krzysiek344/ucore-sevo_driver-integration/hw/rtl/soc/uart_receiver.sv

/* Copyright (C) 2025  AGH University of Krakow */

module uart_receiver (
    input logic        clk,
    input logic        rst_n,

    input logic        sck_rising_edge,
    input logic [7:0]  edges_per_bit,

    output logic       busy,
    output logic       error,
    output logic       rx_data_valid,
    output logic [7:0] rx_data,

    input logic        sin
);


/* User defined types */

typedef enum logic [1:0] {
    IDLE,
    START,
    ACTIVE,
    STOP
} state_t;


/* Local variables and signals */

state_t     state, state_nxt;

logic       rx_data_valid_nxt;
logic [7:0] rx_data_nxt;
logic [2:0] bits_counter, bits_counter_nxt;
logic [7:0] edges_counter, edges_counter_nxt;
logic [7:0] rx_buffer, rx_buffer_nxt;
logic       error_nxt;


/* Module internal logic */

/* State controller */

always_ff @(posedge clk or negedge rst_n) begin
    if (!rst_n) begin
        state <= IDLE;
        bits_counter <= 3'b0;
        edges_counter <= 8'b0;
    end else begin
        state <= state_nxt;
        bits_counter <= bits_counter_nxt;
        edges_counter <= edges_counter_nxt;
    end
end

always_comb begin
    state_nxt = state;
    bits_counter_nxt = bits_counter;
    edges_counter_nxt = edges_counter;

    case (state)
    IDLE: begin
        if (!sin)
            state_nxt = START;
    end
    START: begin
        if (sck_rising_edge) begin
            if (edges_counter == edges_per_bit - 1) begin
                state_nxt = ACTIVE;
                edges_counter_nxt = 8'b0;
            end else begin
                edges_counter_nxt = edges_counter + 1;
            end
        end
    end
    ACTIVE: begin
        if (sck_rising_edge) begin
            if (edges_counter == edges_per_bit - 1) begin
                edges_counter_nxt = 8'b0;

                if (bits_counter == 7) begin
                    state_nxt = STOP;
                    bits_counter_nxt = 3'b0;
                end else begin
                    bits_counter_nxt = bits_counter + 1;
                end
            end else begin
                edges_counter_nxt = edges_counter + 1;
            end
        end
    end
    STOP: begin
        if (sck_rising_edge) begin
            if (edges_counter == (edges_per_bit - 1) >> 1) begin
                state_nxt = IDLE;
                edges_counter_nxt = 8'b0;
            end else begin
                edges_counter_nxt = edges_counter + 1;
            end
        end
    end
    default: ;
    endcase
end

/* Transmission controller */

always_ff @(posedge clk or negedge rst_n) begin
    if (!rst_n) begin
        rx_data_valid <= 1'b0;
        rx_data <= 8'b0;
        error <= 1'b0;
        rx_buffer <= 8'b0;
    end else begin
        rx_data_valid <= rx_data_valid_nxt;
        rx_data <= rx_data_nxt;
        error <= error_nxt;
        rx_buffer <= rx_buffer_nxt;
    end
end

always_comb begin
    busy = 1'b1;
    rx_data_valid_nxt = 1'b0;
    rx_data_nxt = rx_data;
    error_nxt = error;
    rx_buffer_nxt = rx_buffer;

    case (state)
    IDLE: begin
        busy = 1'b0;
    end
    START: begin
        rx_buffer_nxt = 8'b0;
        error_nxt = 1'b0;
    end
    ACTIVE: begin
        if (sck_rising_edge && (edges_counter == (edges_per_bit - 1) >> 1))
            rx_buffer_nxt = {sin, rx_buffer[7:1]};
    end
    STOP: begin
        if (sck_rising_edge) begin
            if (edges_counter == (edges_per_bit - 1) >> 1) begin
                rx_data_valid_nxt = 1'b1;
                rx_data_nxt = rx_buffer;
                error_nxt = ~sin;
            end
        end
    end
    default: ;
    endcase
end

endmodule
