krzysiek344/ucore-sevo_driver-integration/hw/rtl/soc/servo_driver/step_counter.sv

/*
 * Authors:
 *   Oliwier Krupa
 *   Krzysztof Muś
 *
 * Description:
 *   Position counter module for the servo driver.
 */

`timescale 1ns / 1ps

module step_counter #(
    parameter POS_RANGE = 32
)(
    input  logic clk,
    input  logic rst_n,
    output logic [POS_RANGE-1:0] current_pos,
    input  logic step_tick,
    input  logic dir,
    input  logic set_zero  // z poziomu FSM mozesz wyzerowac licznik przez ta zmienna 
    
);

    logic [POS_RANGE-1:0] current_pos_nxt;

    always_ff @(posedge clk or negedge rst_n) begin
        if (!rst_n) begin
            current_pos <= '0;
        end else begin
            current_pos <= current_pos_nxt;
        end
    end

    always_comb begin
        current_pos_nxt = current_pos;

        if (set_zero) begin
            current_pos_nxt = '0;
        end else if (step_tick) begin
            if (dir) begin
                current_pos_nxt = current_pos + 1;
            end else begin
                current_pos_nxt = current_pos - 1;
            end
        end
    end
endmodule
