krzysiek344/ucore-sevo_driver-integration/(commit log)

2026-05-26 add unwrapped servo-driver rtl module
2026-05-29 add servo module wrapper
2026-05-29 integrate servo module with system
2026-05-31 add servo-wrapper unit test base
2026-05-31 initialize 'sensor raw'
2026-05-31 add test for sensor output read, fix other test logic
    [tb_servo_wrapper.sv]
2026-06-03 add servo driver to libsoc
2026-06-03 update soc servo integration test
2026-06-04 integrate servo with FPGA top and C driver
2026-06-10 base prj, only switches
2026-06-10 version with uart
2026-06-10 uart is not collaborating...
2026-06-13 test servo_top
2026-06-13 Handle active-low servo sensor
2026-06-13 Uptade simulations for active-low servo sensor
2026-06-13 small touch active-low servo
2026-06-13 add smth in test servo_wrapper
2026-06-13 change sensor acitve low
